DamianKw1999/Automatyczny-system-nawadniaj-cy/README.md

Kod programu znajduje się w pliku "kod.ino". Dokumentacja znajduje się w pliku "Autonomiczny system nawadniający".
